hRake/aloidia-keyboard/aloidia-pcb/epd/epd.kicad_pcb

## KiCad design aloidia-pcb/epd/epd.kicad_pcb (2022-07-14)

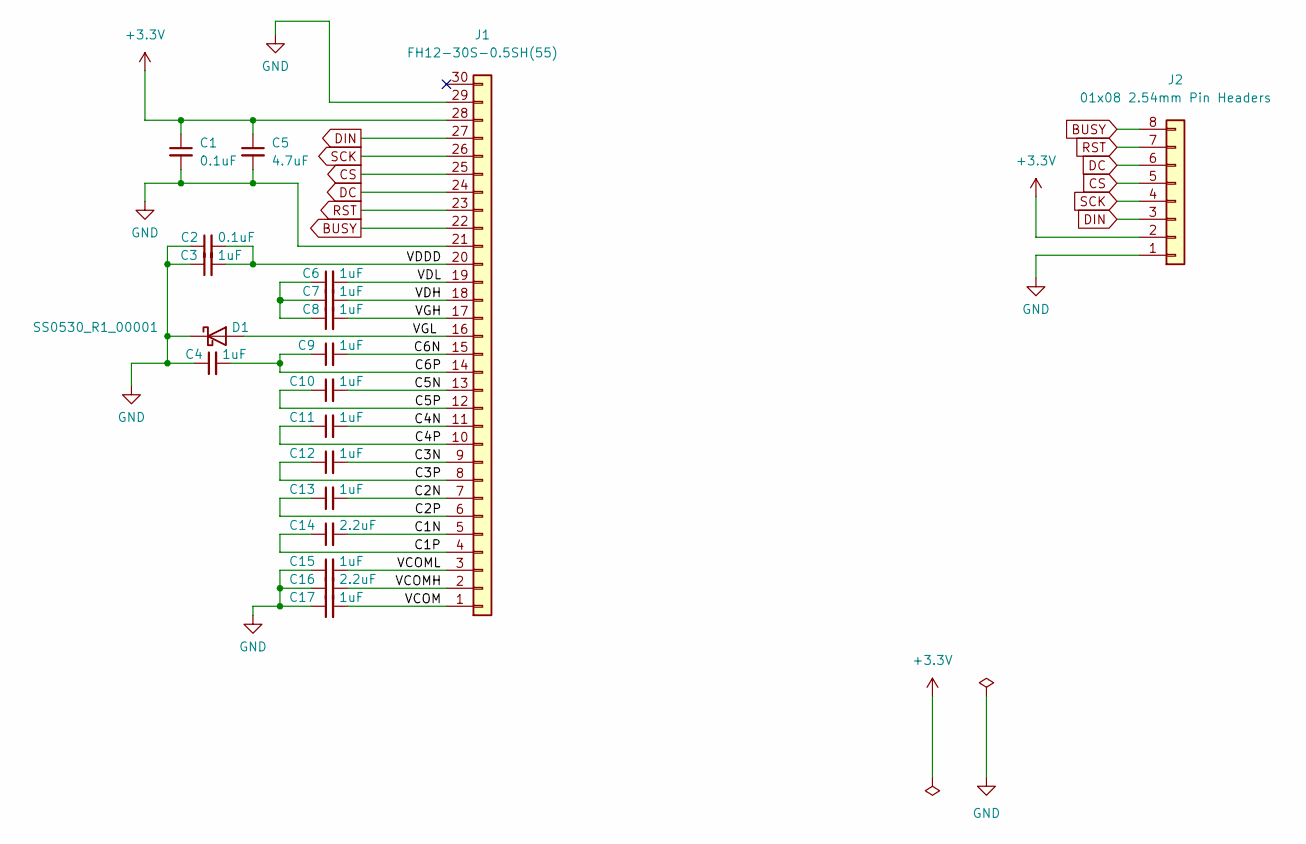
[picture p1: schematic epd.kicad_sch, ALOIDIA Keyboard 1.02 inch e-Paper Display Module]

Parts:
C1, C2: 0.1uF; C_0603_1608Metric
C3, C4, C6, C7, C8, C9, C10, C11, C12, C13, C15, C17: 1uF; C_0603_1608Metric
C5: 4.7uF; C_0603_1608Metric
C14, C16: 2.2uF; C_0603_1608Metric
D1: SS0530_R1_00001; D_SOD-123; Mouser ref 241-SS0530_R1_00001
J1: FH12-30S-0.5SH(55); JUSHUO AFC24-S30FIC-00; Mouser ref 798-FH12-30S-0.5SH55
J2: 01x08 2.54mm Pin Headers; PinHeader_1x08_P2.54mm_Vertical

Connections:
+3.3V: C1.1, C5.1, J1.28, J2.2
/C1N: C14.2, J1.5
/C1P: C14.1, J1.4
/C2N: C13.2, J1.7
/C2P: C13.1, J1.6
/C3N: C12.2, J1.9
/C3P: C12.1, J1.8
/C4N: C11.2, J1.11
/C4P: C11.1, J1.10
/C5N: C10.2, J1.13
/C5P: C10.1, J1.12
/C6N: C9.2, J1.15
/C6P: C4.2, C9.1, J1.14
/VCOM: C17.2, J1.1
/VCOMH: C16.2, J1.2
/VCOML: C15.2, J1.3
/VDDD: C2.2, C3.2, J1.20
/VDH: C7.2, J1.18
/VDL: C6.2, J1.19
/VGH: C8.2, J1.17
/VGL: D1.2 (A), J1.16
BUSY: J1.22, J2.8
CS: J1.25, J2.5
DC: J1.24, J2.6
DIN: J1.27, J2.3
GND: C1.2, C2.1, C3.1, C4.1, C5.2, C15.1, C16.1, C17.1, D1.1 (K), J1.21, J1.29, J2.1
unnamed: C6.1, C7.1, C8.1
RST: J1.23, J2.7
SCK: J1.26, J2.4

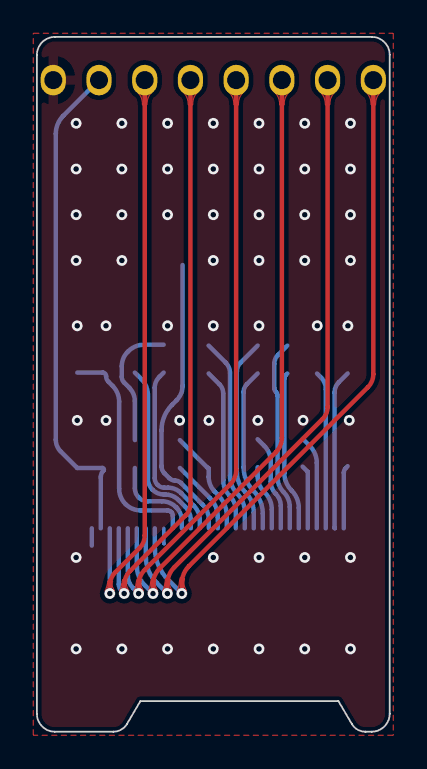
[picture p2: board epd.kicad_pcb from above]

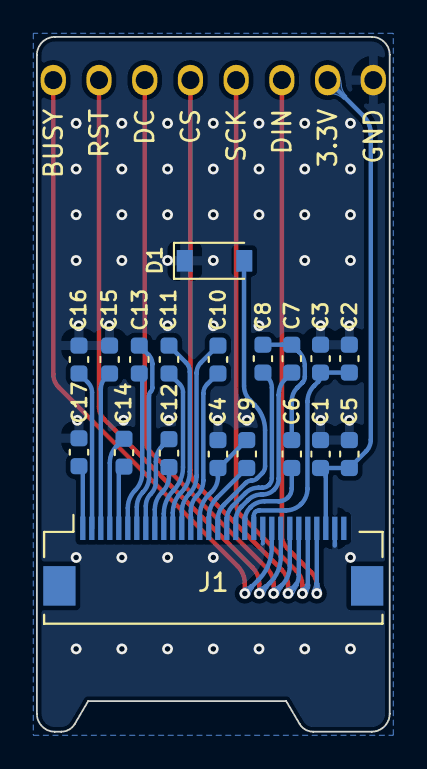
[picture p3: board epd.kicad_pcb from below]

Board: 2 copper layers, 19.6 x 38.6 mm, 20 parts (20 on the bottom side), 29 nets.
