hRake/aloidia-keyboard/aloidia-pcb/solar/solar.kicad_pcb

## KiCad design aloidia-pcb/solar/solar.kicad_pcb (2022-07-12)

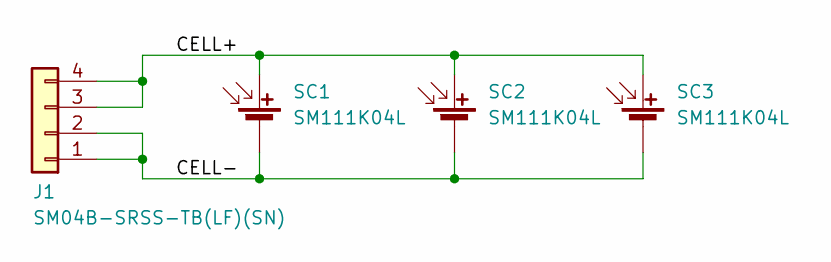
[picture p4: schematic solar.kicad_sch, ALOIDIA Keyboard Solar Cells Breakout Module]

Parts:
J1: SM04B-SRSS-TB(LF)(SN); JST_SH_SM04B-SRSS-TB_1x04-1MP_P1.00mm_Horizontal
SC1, SC2, SC3: SM111K04L; Digikey ref SM111K04L-ND

Connections:
/CELL+: J1.3, J1.4, SC1.1 (+), SC2.1 (+), SC3.1 (+)
/CELL-: J1.1, J1.2, SC1.2 (-), SC2.2 (-), SC3.2 (-)

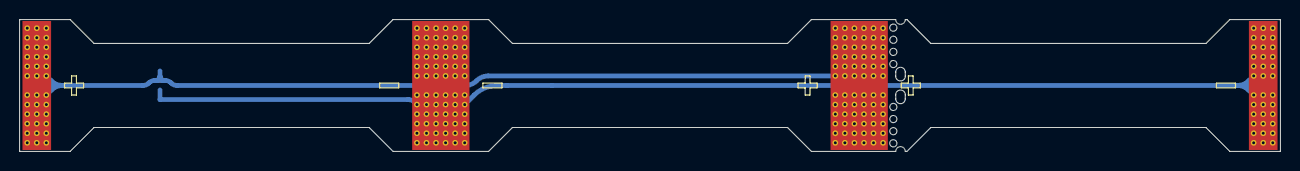
[picture p5: board solar.kicad_pcb from above]

Board: 2 copper layers, 132.0 x 13.8 mm, 4 parts (1 on the bottom side), 2 nets.
