hRake/aloidia-keyboard/aloidia-pcb/aloidia-left/aloidia-left.kicad_pcb

## KiCad design aloidia-pcb/aloidia-left/aloidia-left.kicad_pcb (2022-07-06)

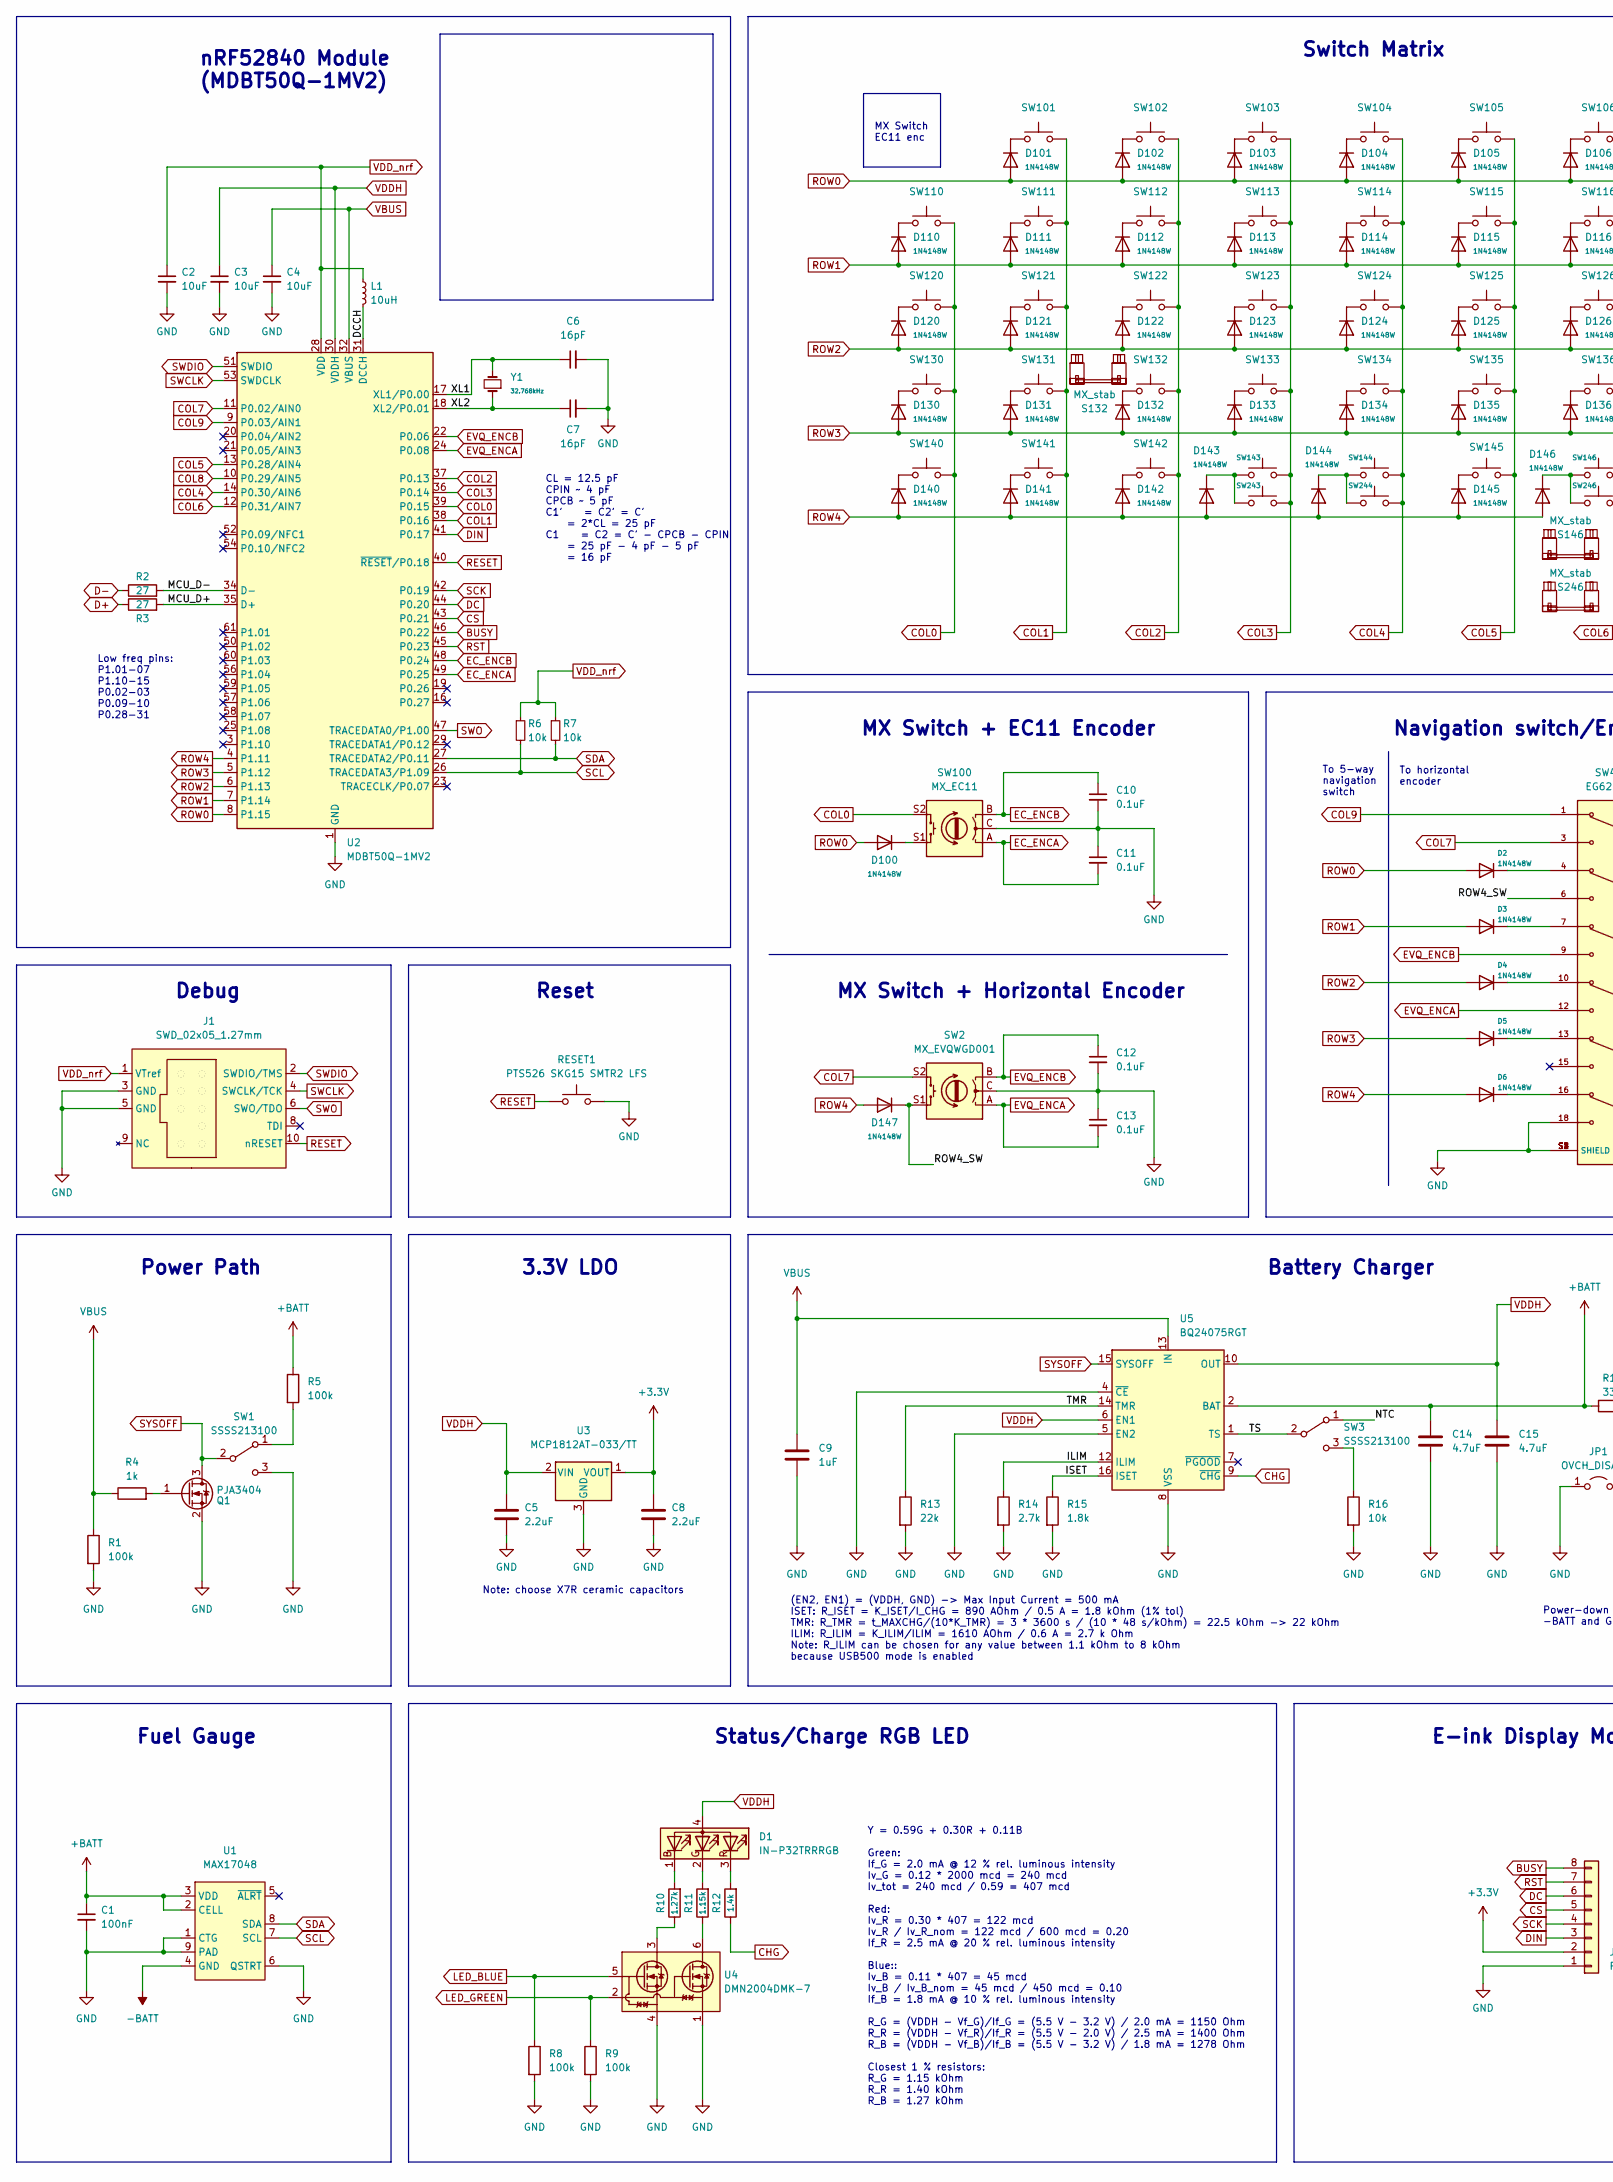
[picture p6: schematic aloidia-left.kicad_sch, ALOIDIA Keyboard Left Side, part in row 1, column 1]

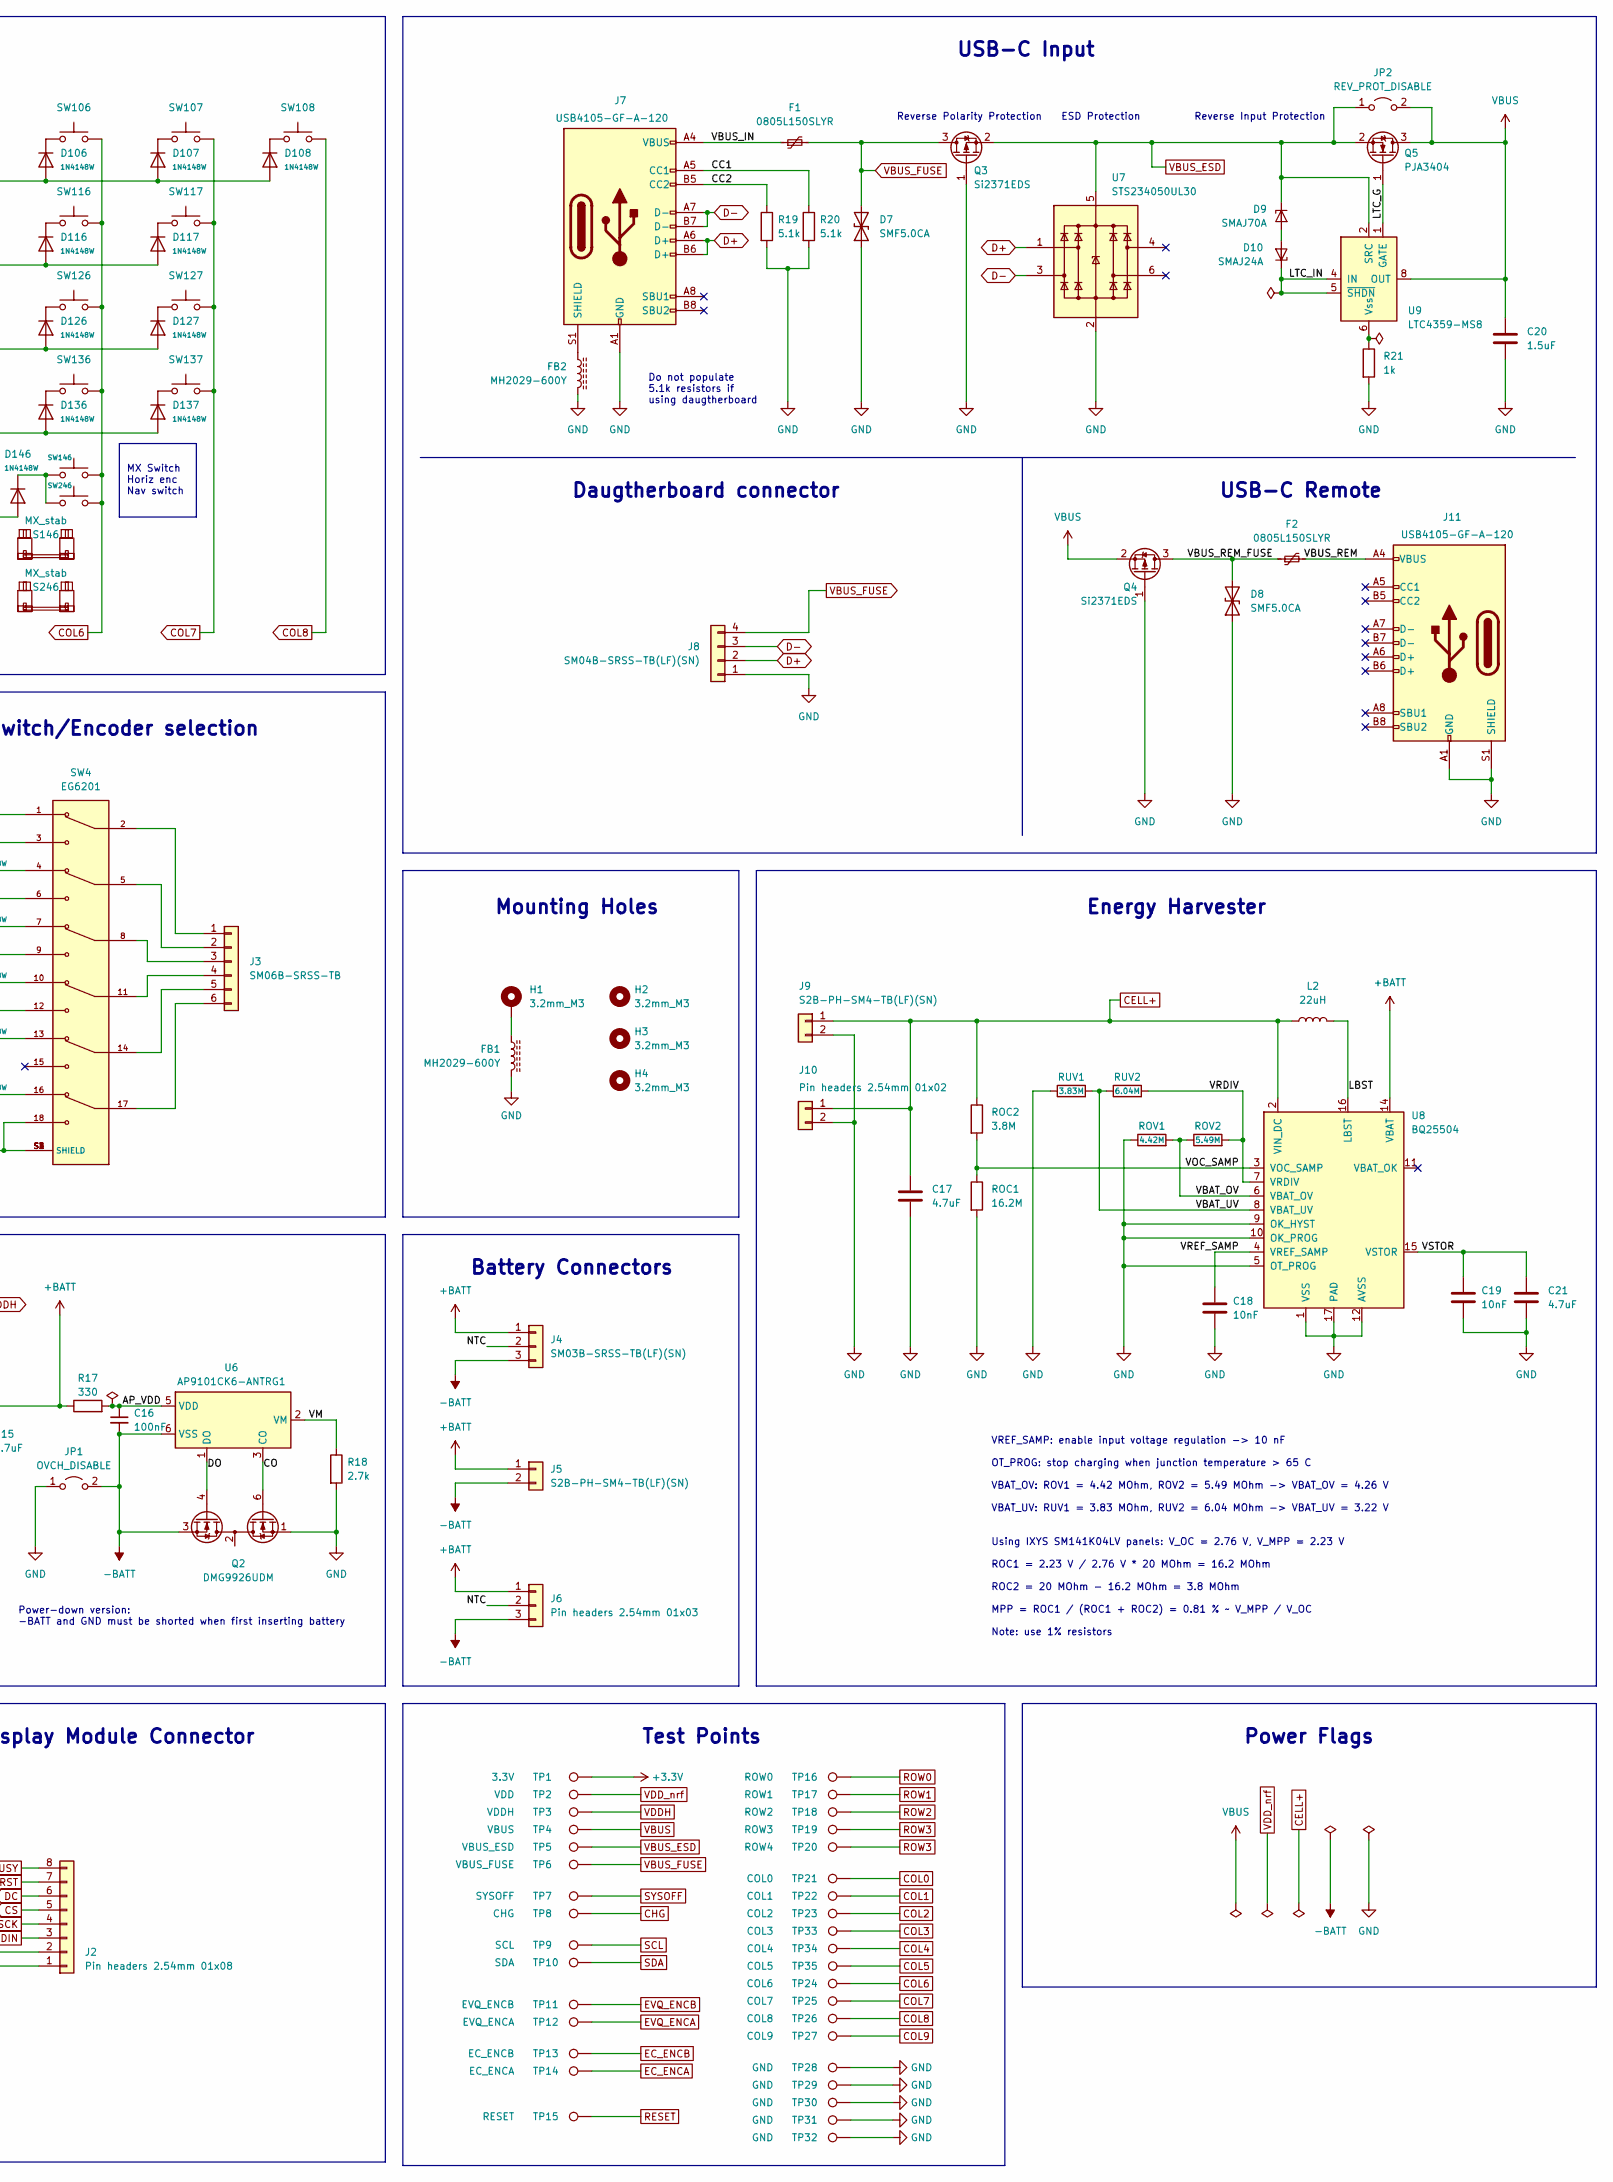
[picture p7: schematic aloidia-left.kicad_sch, ALOIDIA Keyboard Left Side, part in row 1, column 2]

Parts:
C1, C16: 100nF; C_0603_1608Metric
C2, C3, C4: 10uF; C_0603_1608Metric
C5, C8: 2.2uF; C_0603_1608Metric
C6, C7: 16pF; C_0603_1608Metric
C9: 1uF; C_0603_1608Metric
C10, C11, C12, C13: 0.1uF; C_0603_1608Metric
C14, C15, C17, C21: 4.7uF; C_0603_1608Metric
C18, C19: 10nF; C_0603_1608Metric
C20: 1.5uF; C_0603_1608Metric
D1: IN-P32TRRRGB; Mouser ref 743-IN-P32TRRRGB
D2, D3, D4, D5, D6, D100, D101, D102, D103, D104, D105, D106, D107, D108, D110, D111, D112, D113, D114, D115, D116, D117, D120, D121, D122, D123, D124, D125, D126, D127, D130, D131, D132, D133, D134, D135, D136, D137, D140, D141, D142, D143, D144, D145, D146, D147: 1N4148W; D_SOD-123
D7, D8: SMF5.0CA; D_SOD-123; Mouser ref 576-SMF5.0CA
D9: SMAJ70A; D_SMA; Mouser ref 576-SMAJ24A
D10: SMAJ24A; D_SMA; Mouser ref 652-SMAJ70A
F1, F2: 0805L150SLYR; Fuse_0805_2012Metric; Mouser ref 576-0805L150SLYR
FB1, FB2: MH2029-600Y; L_0805_2012Metric
H1, H2, H3, H4: 3.2mm_M3; MountingHole_3.2mm_M3_Pad_Via
J1: SWD_02x05_1.27mm; FTSH-105-01; Mouser ref 485-4048
J2: Pin headers 2.54mm 01x08; PinHeader_1x08_P2.54mm_Vertical
J3: SM06B-SRSS-TB; JST_SH_SM06B-SRSS-TB_1x06-1MP_P1.00mm_Horizontal
J4: SM03B-SRSS-TB(LF)(SN); JST_SH_SM03B-SRSS-TB_1x03-1MP_P1.00mm_Horizontal
J5, J9: S2B-PH-SM4-TB(LF)(SN); JST_PH_S2B-PH-SM4-TB_1x02-1MP_P2.00mm_Horizontal
J6: Pin headers 2.54mm 01x03; PinSocket_1x03_P2.54mm_Vertical
J7, J11: USB4105-GF-A-120; USB_C_Receptacle_HRO_TYPE-C-31-M-12; Mouser ref 640-USB4105-GF-A-120
J8: SM04B-SRSS-TB(LF)(SN); JST_SH_SM04B-SRSS-TB_1x04-1MP_P1.00mm_Horizontal
J10: Pin headers 2.54mm 01x02; PinHeader_1x02_P2.54mm_Vertical
JP1: OVCH_DISABLE; SolderJumper-2_P1.3mm_Open_RoundedPad1.0x1.5mm
JP2: REV_PROT_DISABLE; SolderJumper-2_P1.3mm_Open_RoundedPad1.0x1.5mm
L1: 10uH; L_0603_1608Metric
L2: 22uH; L_0603_1608Metric
Q1, Q5: PJA3404; SOT-23; Mouser ref 241-PJA3404_R1_00001
Q2: DMG9926UDM; SOT-23-6; Mouser ref 621-DMG9926UDM-7
Q3, Q4: Si2371EDS; SOT-23; Mouser ref 78-SI2371EDS-T1-BE3
R1, R5, R8, R9: 100k; R_0603_1608Metric
R2, R3: 27; R_0603_1608Metric
R4, R21: 1k; R_0603_1608Metric
R6, R7, R16: 10k; R_0603_1608Metric
R10: 1.27k; R_0603_1608Metric
R11: 1.15k; R_0603_1608Metric
R12: 1.4k; R_0603_1608Metric
R13: 22k; R_0603_1608Metric
R14, R18: 2.7k; R_0603_1608Metric
R15: 1.8k; R_0603_1608Metric
R17: 330; R_0603_1608Metric
R19, R20: 5.1k; R_0603_1608Metric
RESET1: PTS526 SKG15 SMTR2 LFS; PTS526; Mouser ref 611-PTS526SKG15SMR2L
ROC1: 16.2M; R_0603_1608Metric
ROC2: 3.8M; R_0603_1608Metric
ROV1: 4.42M; R_0603_1608Metric
ROV2: 5.49M; R_0603_1608Metric
RUV1: 3.83M; R_0603_1608Metric
RUV2: 6.04M; R_0603_1608Metric
S132, S146: MX_stab; STAB_MX_P_2.25u
S246: MX_stab; STAB_MX_P_2.75u
SW1, SW3: SSSS213100; SW_SSSS213100; Mouser ref 688-SSSS213100
SW2: MX_EVQWGD001; MX_HS_AS_1u_EVQWGD001
SW4: EG6201; SW_EG6201; Mouser ref 612-EG6201
SW100: MX_EC11; MX_HS_AS_EC11_1u
SW101, SW102, SW103, SW104, SW105, SW106, SW107, SW108, SW110, SW111, SW113, SW114, SW115, SW116, SW117, SW120, SW121, SW123, SW124, SW125, SW126, SW127, SW130, SW131, SW132, SW133, SW134, SW135, SW136, SW137, SW140, SW141, SW145, SW146, SW243, SW246: SW_Push; MX_HS_AS_1u
SW112, SW144: SW_Push; MX_HS_AS_1.5u
SW122: SW_Push; MX_HS_AS_1.75u
SW142, SW143, SW244: SW_Push; MX_HS_AS_1.25u
TP1: 3.3V; TestPoint
TP2: VDD; TestPoint
TP3: VDDH; TestPoint
TP4: VBUS; TestPoint
TP5: VBUS_ESD; TestPoint
TP6: VBUS_FUSE; TestPoint
TP7: SYSOFF; TestPoint
TP8: CHG; TestPoint
TP9: SCL; TestPoint
TP10: SDA; TestPoint
TP11: EVQ_ENCB; TestPoint
TP12: EVQ_ENCA; TestPoint
TP13: EC_ENCB; TestPoint
TP14: EC_ENCA; TestPoint
TP15: RESET; TestPoint
TP16: ROW0; TestPoint
TP17: ROW1; TestPoint
TP18: ROW2; TestPoint
TP19: ROW3; TestPoint
TP20: ROW4; TestPoint
TP21: COL0; TestPoint
TP22: COL1; TestPoint
TP23: COL2; TestPoint
TP24: COL6; TestPoint
TP25: COL7; TestPoint
TP26: COL8; TestPoint
TP27: COL9; TestPoint
TP28, TP29, TP30, TP31, TP32: GND; TestPoint
TP33: COL3; TestPoint
TP34: COL4; TestPoint
TP35: COL5; TestPoint
U1: MAX17048; TDFN-8-1EP_2x2mm_P0.5mm_EP0.8x1.2mm; Mouser ref 700-MAX17048G+T10
U2: MDBT50Q-1MV2; Raytac_MDBT50Q
U3: MCP1812AT-033/TT; SOT-23; Mouser ref 579-MCP1812AT-033/TT
U4: DMN2004DMK-7; SOT-23-6; Digikey ref DMN2004DMKDICT-ND
U5: BQ24075RGT; VQFN-16-1EP_3x3mm_P0.5mm_EP1.6x1.6mm; Mouser ref 595-BQ24075RGTR
U6: AP9101CK6-ANTRG1; SOT-23-6; Digikey ref AP9101CK6-ANTRG1DICT-ND
U7: STS234050UL30; SOT-23-6; Mouser ref 504-STS234050UL30
U8: BQ25504; VQFN-16-1EP_3x3mm_P0.5mm_EP1.6x1.6mm; Mouser ref 595-BQ25504RGTR
U9: LTC4359-MS8; MSOP-8_3x3mm_P0.65mm
Y1: 32.768kHz; Crystal_SMD_MicroCrystal_CM9V-T1A-2Pin_1.6x1.0mm

Connections:
+3.3V: C8.1, J2.2, TP1.1, U3.1 (VOUT)
+BATT: C1.1, C14.1, J4.1, J5.1, J6.1, R5.1, R17.1, U1.2 (CELL), U1.3 (VDD), U5.2 (BAT), U5.3 (BAT), U8.14 (VBAT)
-BATT: C16.2, J4.3, J5.2, J6.3, JP1.2 (B), Q2.3 (S2), U1.4 (GND), U6.6 (VSS)
/AP_VDD: C16.1, R17.2, U6.5 (VDD)
/CC1: J7.A5 (CC1), R20.1
/CC2: J7.B5 (CC2), R19.1
/CO: Q2.6 (G1), U6.3 (CO)
/DCCH: L1.2, U2.31 (DCCH)
/DO: Q2.4 (G2), U6.1 (DO)
/ILIM: R14.1, U5.12 (ILIM)
/ISET: R15.1, U5.16 (ISET)
/LBST: L2.2, U8.16 (LBST)
/LTC_G: Q5.1 (G), U9.1 (GATE)
/LTC_IN: D10.1 (K1), U9.4 (IN), U9.5 (~SHDN)
/MCU_D+: R3.2, U2.35 (D+)
/MCU_D-: R2.2, U2.34 (D-)
/NTC: J4.2, J6.2, SW3.1 (A)
/ROW4_SW: D147.1 (K), SW2.S1, SW4.6
/TMR: R13.1, U5.14 (TMR)
/TS: SW3.2 (B), U5.1 (TS)
/VBAT_OV: ROV1.2, ROV2.1, U8.6 (VBAT_OV)
/VBAT_UV: RUV1.2, RUV2.1, U8.8 (VBAT_UV)
/VBUS_IN: F1.1, J7.A4 (VBUS), J7.A9 (VBUS), J7.B4 (VBUS), J7.B9 (VBUS)
/VBUS_REM: F2.2, J11.A4 (VBUS), J11.A9 (VBUS), J11.B4 (VBUS), J11.B9 (VBUS)
/VBUS_REM_FUSE: D8.2 (A2), F2.1, Q4.3 (D)
/VM: R18.1, U6.2 (VM)
/VOC_SAMP: ROC1.1, ROC2.2, U8.3 (VOC_SAMP)
/VRDIV: ROV2.2, RUV2.2, U8.7 (VRDIV)
/VREF_SAMP: C18.1, U8.4 (VREF_SAMP)
/VSTOR: C19.1, C21.1, U8.15 (VSTOR)
/XL1: C6.1, U2.17 (XL1/P0.00), Y1.2
/XL2: C7.1, U2.18 (XL2/P0.01), Y1.1
BUSY: J2.8, U2.46 (P0.22)
CELL+: C17.1, J9.1, J10.1, L2.1, ROC2.1, U8.2 (VIN_DC)
CHG: R12.1, TP8.1, U5.9 (~CHG)
COL0: SW100.S2, SW110.2, SW120.2, SW130.2, SW140.2, TP21.1, U2.39 (P0.15)
COL1: SW101.2, SW111.2, SW121.2, SW131.2, SW141.2, TP22.1, U2.38 (P0.16)
COL2: SW102.2, SW112.2, SW122.2, SW132.2, SW142.2, TP23.1, U2.37 (P0.13)
COL3: SW103.2, SW113.2, SW123.2, SW133.2, SW143.2, SW243.2, TP33.1, U2.36 (P0.14)
COL4: SW104.2, SW114.2, SW124.2, SW134.2, SW144.2, SW244.2, TP34.1, U2.14 (P0.30/AIN6)
COL5: SW105.2, SW115.2, SW125.2, SW135.2, SW145.2, TP35.1, U2.13 (P0.28/AIN4)
COL6: SW106.2, SW116.2, SW126.2, SW136.2, SW146.2, SW246.2, TP24.1, U2.12 (P0.31/AIN7)
COL7: SW2.S2, SW4.3, SW107.2, SW117.2, SW127.2, SW137.2, TP25.1, U2.11 (P0.02/AIN0)
COL8: SW108.2, TP26.1, U2.10 (P0.29/AIN5)
COL9: SW4.1, TP27.1, U2.9 (P0.03/AIN1)
CS: J2.5, U2.43 (P0.21)
D+: J7.A6 (D+), J7.B6 (D+), J8.2, R3.1, U7.1 (IO1)
D-: J7.A7 (D-), J7.B7 (D-), J8.3, R2.1, U7.3 (IO2)
DC: J2.6, U2.44 (P0.20)
DIN: J2.3, U2.41 (P0.17)
EC_ENCA: C11.2, SW100.A, TP14.1, U2.49 (P0.25)
EC_ENCB: C10.1, SW100.B, TP13.1, U2.48 (P0.24)
EVQ_ENCA: C13.2, SW2.A, SW4.12, TP12.1, U2.24 (P0.08)
EVQ_ENCB: C12.1, SW2.B, SW4.9, TP11.1, U2.22 (P0.06)
GND: C1.2, C2.2, C3.2, C4.2, C5.2, C6.2, C7.2, C8.2, C9.2, C10.2, C11.1, C12.2, C13.1, C14.2, C15.2, C17.2, C18.2, C19.2, C20.2, C21.2, D7.1 (A1), D8.1 (A1), FB1.2, FB2.2, J1.3 (GND), J1.5 (GND), J2.1, J7.A1 (GND), J7.A12 (GND), J7.B1 (GND), J7.B12 (GND), J8.1, J9.2, J10.2, J11.A1 (GND), J11.A12 (GND), J11.B1 (GND), J11.B12 (GND), J11.S1 (SHIELD), JP1.1 (A), Q1.2 (S), Q2.1 (D1), Q3.1 (G), Q4.1 (G), R1.2, R8.2, R9.2, R13.2, R14.2, R15.2, R16.2, R18.2, R19.2, R20.2, R21.2, RESET1.2, ROC1.2, ROV1.1, RUV1.1, SW1.3 (C), SW2.C, SW4.18, SW4.S1 (SHIELD), SW4.S2 (SHIELD), SW4.S3 (SHIELD), SW4.S4 (SHIELD), SW100.C, TP28.1, TP29.1, TP30.1, TP31.1, TP32.1, U1.1 (CTG), U1.6 (QSTRT), U1.9 (PAD), U2.1 (GND), U2.2 (GND), U2.15 (GND), U2.33 (GND), U2.55 (GND), U3.3 (GND), U4.1 (S2), U4.4 (S1), U5.4 (~CE), U5.5 (EN2), U5.8 (VSS), U5.17 (VSS), U7.2 (VN), U8.1 (VSS), U8.5 (OT_PROG), U8.9 (OK_HYST), U8.10 (OK_PROG), U8.12 (AVSS), U8.13 (VSS), U8.17 (PAD)
LED_BLUE: R8.1, U4.5 (G1)
LED_GREEN: R9.1, U4.2 (G2)
unnamed: D1.1 (BK), R10.2
unnamed: D1.2 (GK), R11.2
unnamed: D1.3 (RK), R12.2
unnamed: D2.1 (K), SW4.4
unnamed: D3.1 (K), SW4.7
unnamed: D4.1 (K), SW4.10
unnamed: D5.1 (K), SW4.13
unnamed: D6.1 (K), SW4.16
unnamed: D9.2 (A), D10.2 (A)
unnamed: D100.1 (K), SW100.S1
unnamed: D101.1 (K), SW101.1
unnamed: D102.1 (K), SW102.1
unnamed: D103.1 (K), SW103.1
unnamed: D104.1 (K), SW104.1
unnamed: D105.1 (K), SW105.1
unnamed: D106.1 (K), SW106.1
unnamed: D107.1 (K), SW107.1
unnamed: D108.1 (K), SW108.1
unnamed: D110.1 (K), SW110.1
unnamed: D111.1 (K), SW111.1
unnamed: D112.1 (K), SW112.1
unnamed: D113.1 (K), SW113.1
unnamed: D114.1 (K), SW114.1
unnamed: D115.1 (K), SW115.1
unnamed: D116.1 (K), SW116.1
unnamed: D117.1 (K), SW117.1
unnamed: D120.1 (K), SW120.1
unnamed: D121.1 (K), SW121.1
unnamed: D122.1 (K), SW122.1
unnamed: D123.1 (K), SW123.1
unnamed: D124.1 (K), SW124.1
unnamed: D125.1 (K), SW125.1
unnamed: D126.1 (K), SW126.1
unnamed: D127.1 (K), SW127.1
unnamed: D130.1 (K), SW130.1
unnamed: D131.1 (K), SW131.1
unnamed: D132.1 (K), SW132.1
unnamed: D133.1 (K), SW133.1
unnamed: D134.1 (K), SW134.1
unnamed: D135.1 (K), SW135.1
unnamed: D136.1 (K), SW136.1
unnamed: D137.1 (K), SW137.1
unnamed: D140.1 (K), SW140.1
unnamed: D141.1 (K), SW141.1
unnamed: D142.1 (K), SW142.1
unnamed: D143.1 (K), SW143.1, SW243.1
unnamed: D144.1 (K), SW144.1, SW244.1
unnamed: D145.1 (K), SW145.1
unnamed: D146.1 (K), SW146.1, SW246.1
unnamed: FB1.1, H1.1
unnamed: FB2.1, J7.S1 (SHIELD)
unnamed: J3.1, SW4.2
unnamed: J3.2, SW4.5
unnamed: J3.3, SW4.8
unnamed: J3.4, SW4.11
unnamed: J3.5, SW4.14
unnamed: J3.6, SW4.17
unnamed: Q1.1 (G), R4.2
unnamed: Q2.2 (S1/D2), Q2.5 (S1/D2)
unnamed: R5.2, SW1.1 (A)
unnamed: R10.1, U4.3 (D1)
unnamed: R11.1, U4.6 (D2)
unnamed: R16.1, SW3.3 (C)
unnamed: R21.1, U9.6 (Vss)
RESET: J1.10 (nRESET), RESET1.1, TP15.1, U2.40 (~RESET/P0.18)
ROW0: D2.2 (A), D100.2 (A), D101.2 (A), D102.2 (A), D103.2 (A), D104.2 (A), D105.2 (A), D106.2 (A), D107.2 (A), D108.2 (A), TP16.1, U2.8 (P1.15)
ROW1: D3.2 (A), D110.2 (A), D111.2 (A), D112.2 (A), D113.2 (A), D114.2 (A), D115.2 (A), D116.2 (A), D117.2 (A), TP17.1, U2.7 (P1.14)
ROW2: D4.2 (A), D120.2 (A), D121.2 (A), D122.2 (A), D123.2 (A), D124.2 (A), D125.2 (A), D126.2 (A), D127.2 (A), TP18.1, U2.6 (P1.13)
ROW3: D5.2 (A), D130.2 (A), D131.2 (A), D132.2 (A), D133.2 (A), D134.2 (A), D135.2 (A), D136.2 (A), D137.2 (A), TP19.1, TP20.1, U2.5 (P1.12)
ROW4: D6.2 (A), D140.2 (A), D141.2 (A), D142.2 (A), D143.2 (A), D144.2 (A), D145.2 (A), D146.2 (A), D147.2 (A), U2.4 (P1.11)
RST: J2.7, U2.45 (P0.23)
SCK: J2.4, U2.42 (P0.19)
SCL: R6.2, TP9.1, U1.7 (SCL), U2.26 (TRACEDATA3/P1.09)
SDA: R7.2, TP10.1, U1.8 (SDA), U2.27 (TRACEDATA2/P0.11)
SWCLK: J1.4 (SWCLK/TCK), U2.53 (SWDCLK)
SWDIO: J1.2 (SWDIO/TMS), U2.51 (SWDIO)
SWO: J1.6 (SWO/TDO), U2.47 (TRACEDATA0/P1.00)
SYSOFF: Q1.3 (D), SW1.2 (B), TP7.1, U5.15 (SYSOFF)
VBUS: C4.1, C9.1, C20.1, JP2.2 (B), Q4.2 (S), Q5.3 (D), R1.1, R4.1, TP4.1, U2.32 (VBUS), U5.13 (IN), U9.8 (OUT)
VBUS_ESD: D9.1 (K1), JP2.1 (A), Q3.2 (S), Q5.2 (S), TP5.1, U7.5 (VP), U9.2 (SRC)
VBUS_FUSE: D7.2 (A2), F1.2, J8.4, Q3.3 (D), TP6.1
VDDH: C3.1, C5.1, C15.1, D1.4 (A), TP3.1, U2.30 (VDDH), U3.2 (VIN), U5.6 (EN1), U5.10 (OUT), U5.11 (OUT)
VDD_nrf: C2.1, J1.1 (VTref), L1.1, R6.1, R7.1, TP2.1, U2.28 (VDD)

Notes on the sheet:
MX Switch EC11 enc
Reverse Polarity Protection
nRF52840 Module (MDBT50Q-1MV2)
Switch Matrix
To horizontal encoder
Reverse Input Protection
CL = 12.5 pF CPIN ~ 4 pF CPCB ~ 5 pF C1' = C2' = C' = 2*CL = 25 pF C1 = C2 = C' - CPCB - CPIN = 25 pF - 4 pF - 5 pF = 16 pF
Mounting Holes
ESD Protection
(EN2, EN1) = (VDDH, GND) -> Max Input Current = 500 mA ISET: R_ISET = K_ISET/I_CHG = 890 AOhm / 0.5 A = 1.8 kOhm (1% tol) TMR: R_TMR = t_MAXCHG/(10*K_TMR) = 3 * 3600 s / (10 * 48 s/kOhm) = 22.5 kOhm -> 22 kOhm ILIM: R_ILIM = K_ILIM/ILIM = 1610 AOhm / 0.6 A = 2.7 k Ohm Note: R_ILIM can be chosen for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
Power Flags
MX Switch + Horizontal Encoder
Power-down version: -BATT and GND must be shorted when first inserting battery
Energy Harvester
MX Switch + EC11 Encoder
MX Switch Horiz enc Nav switch
Navigation switch/Encoder selection
Daugtherboard connector
VREF_SAMP: enable input voltage regulation -> 10 nF OT_PROG: stop charging when junction temperature > 65 C VBAT_OV: ROV1 = 4.42 MOhm, ROV2 = 5.49 MOhm -> VBAT_OV = 4.26 V VBAT_UV: RUV1 = 3.83 MOhm, RUV2 = 6.04 MOhm -> VBAT_UV = 3.22 V Using IXYS SM141K04LV panels: V_OC = 2.76 V, V_MPP = 2.23 V ROC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
To 5-way navigation switch
Low freq pins: P1.01-07 P1.10-15 P0.02-03 P0.09-10 P0.28-31
Debug
Reset
USB-C Input
Fuel Gauge
Battery Connectors
Test Points
Battery Charger
Power Path
E-ink Display Module Connector
Y = 0.59G + 0.30R + 0.11B Green: If_G = 2.0 mA @ 12 % rel. luminous intensity Iv_G = 0.12 * 2000 mcd = 240 mcd Iv_tot = 240 mcd / 0.59 = 407 mcd Red: Iv_R = 0.30 * 407 = 122 mcd Iv_R / Iv_R_nom = 122 mcd / 600 mcd = 0.20 If_R = 2.5 mA @ 20 % rel. luminous intensity Blue:: Iv_B = 0.11 * 407 = 45 mcd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
Do not populate 5.1k resistors if using daugtherboard
3.3V LDO
USB-C Remote
Note: choose X7R ceramic capacitors
Status/Charge RGB LED

Board: 2 copper layers, 223 parts (0 on the bottom side), 140 nets, no tracks yet.
