hRake/aloidia-keyboard/(commit log)

2022-07-06 Finished schematics of left half
    [aloidia-left.kicad_sch]
2022-07-06 Assigned all footprints
    [aloidia-left.kicad_sch]
2022-07-06 Added design rules, net classes constraints and all footprint 3d models
    [aloidia-left.kicad_pcb, aloidia-left.kicad_sch]
2022-07-09 Routed left side
    [aloidia-left.kicad_sch]
2022-07-10 Added production files for e-paper display module
    [BOM-epd.csv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]
2022-07-10 Changed page settings
    [epd.kicad_pcb]
2022-07-10 Added pin legends
    [epd-CuBottom.gbr, epd-CuTop.gbr, epd-EdgeCuts.gbr, epd-MaskBottom.gbr, epd-MaskTop.gbr, epd-NPTH.drl, epd-PTH.drl, epd-PasteBottom.gbr]
2022-07-10 Fixed user comments alignment and metadata
    [epd.kicad_pcb]
2022-07-10 Fixed text labels orientation
    [epd-CuBottom.gbr, epd-CuTop.gbr, epd-EdgeCuts.gbr, epd-MaskBottom.gbr, epd-MaskTop.gbr, epd-NPTH.drl, epd-PTH.drl, epd-PasteBottom.gbr]
2022-07-10 Added e-Paper display mechanical footprint
    [aloidia-left.kicad_sch]
2022-07-10 Added solar cells breakout module
    [solar.kicad_pcb, solar.kicad_sch]
2022-07-10 Added solar breakout module outline dimensions
    [solar.kicad_pcb]
2022-07-10 Locked mousebites
    [solar.kicad_pcb]
2022-07-10 Added connector 3d model
    [solar.kicad_pcb]
2022-07-10 Added solar breakout module physical footprint
    [solar.kicad_pcb]
2022-07-10 Moved diode up
    [POS-epd.csv, epd-CuBottom.gbr, epd-CuTop.gbr, epd-EdgeCuts.gbr, epd-MaskBottom.gbr, epd-MaskTop.gbr, epd-NPTH.drl, epd-PTH.drl]
2022-07-10 Extended mcu ground keepout zone
    [aloidia-right.kicad_sch]
2022-07-10 Changed silkscreen text size
2022-07-12 Changed connectors to jst-sh
    [aloidia-left.kicad_sch, solar.kicad_pcb, solar.kicad_sch]
2022-07-14 Adjusted trace widths
    [aloidia-left.kicad_sch]
2022-07-14 FInished routing right side
    [aloidia-right.kicad_sch]
2022-07-14 Added 1mm mousebite footprints
2022-07-14 Rectified stackup colors
    [epd.kicad_pcb]
2022-07-14 Added unconnected symbols
    [aloidia-right.kicad_sch]
